7yns7/Thales-Contest/report/fft_after.jpg

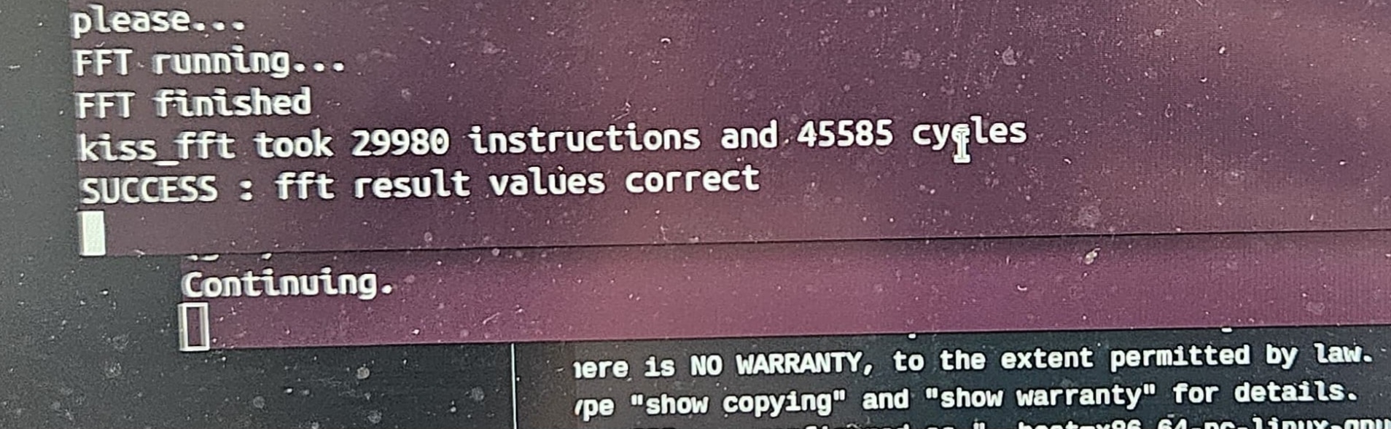
report/fft_after.jpg
