7yns7/Thales-Contest/corev_apu/fpga/cva6_fpga.runs/impl_1/.init_design.begin.rst

<?xml version="1.0"?>
<ProcessHandle Version="1" Minor="0">
    <Process Command=".planAhead." Owner="younes" Host="" Pid="8735">
    </Process>
</ProcessHandle>
