7yns7/Thales-Contest/corev_apu/fpga/cva6_fpga.runs/impl_1/.vivado.begin.rst

<?xml version="1.0"?>
<ProcessHandle Version="1" Minor="0">
    <Process Command="vivado" Owner="younes" Host="Younes" Pid="8663" HostCore="16" HostMemory="16054204">
    </Process>
</ProcessHandle>
<?xml version="1.0"?>
<ProcessHandle Version="1" Minor="0">
    <Process Command="vivado" Owner="younes" Host="Younes" Pid="61534" HostCore="16" HostMemory="16054204">
    </Process>
</ProcessHandle>
