7yns7/Thales-Contest/corev_apu/fpga/cva6_fpga.runs/impl_1/clockInfo.txt

-------------------------------------
| Tool Version : Vivado v.2024.1
| Date         : Fri Mar 13 12:33:33 2026
| Host         : Younes
| Design       : checkpoint_cva6_zybo_z7_20
| Device       : xc7z020-clg400-1--
-------------------------------------

For more information on clockInfo.txt clock routing debug file see https://support.xilinx.com/s/article/000035660?language=en_US
