7yns7/Thales-Contest/(commit log)

2026-03-01 feat: FFT acceleration custom ISA extensions
    - ALU: CADD16, CSUB16, CMUL16, CMADD16, CMSUB16 (packed complex Q15)
    - MULT: BFY2/BFY2H (radix-2 butterfly), BFY4_S0..O3 (radix-4 butterfly)
    - MULT: Twiddle cache (512 entries), TWLD/TWCFG instructions
    - MULT: Fused div4 scaling in BFY4
    - Software: kissfft intrinsics, twiddle preloading, build flags
2026-03-03 refactor: rename 'twiddle cache' → 'twiddle register file' for contest compliance
    - RTL: twiddle_cache_en_q → twiddle_rf_en_q in core/mult.sv
    - SW: KISSFFT_USE_TWIDDLE_CACHE → KISSFFT_USE_TWIDDLE_RF in C sources & Makefile
    - Docs: updated all references in FFT_ACCELERATION.md, FFT_ISA_EXTENSIONS.md, FFT_SOFTWARE_GUIDE.md
    Avoids confusion with the contest rule 'pas d'augmentation de la taille du cache'.
    The twiddle storage is a dedicated 512×32-bit register file inside the MULT unit,
    not part of the data/instruction cache hierarchy.
    [mult.sv]
2026-04-24 Aplatir la récursion kf_work (FFT-512)
2026-04-29 Set default Xilinx board/part
